ephrenm/ETBC/ETBC Hardware Files/Project Outputs for ETBC/PCB 3D Print/ETBC.jpg

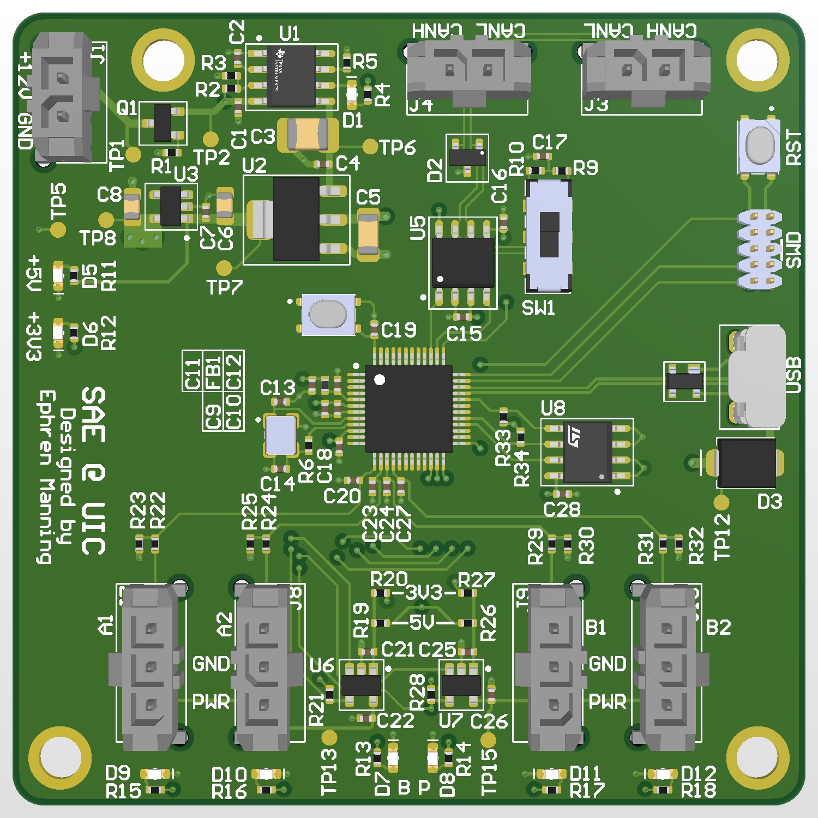
ETBC Hardware Files/Project Outputs for ETBC/PCB 3D Print/ETBC.jpg
