ephrenm/ETBC/README.md

# Electronic Throttle & Brake Controller (ETBC)
PCB designed to serve as the main controller for the brake and throttle pedal sensors on UIC's Student Formula Electric competition car. Uses an STM32G0 Cortex-M0+ in order to read analog sensor values and check for error conditions. Pedal position is communicated to the main vehicle controller using CAN 2.0A. Current version is Rev. A.

ETBC

Soldered using stencil and paste:


Designed with Altium Designer by Ephren Manning. Hardware files folder contains all design files and gerbers.
