ephrenm/ETBC/ETBC Hardware Files/Project Outputs for ETBC/Cover Page.pdf

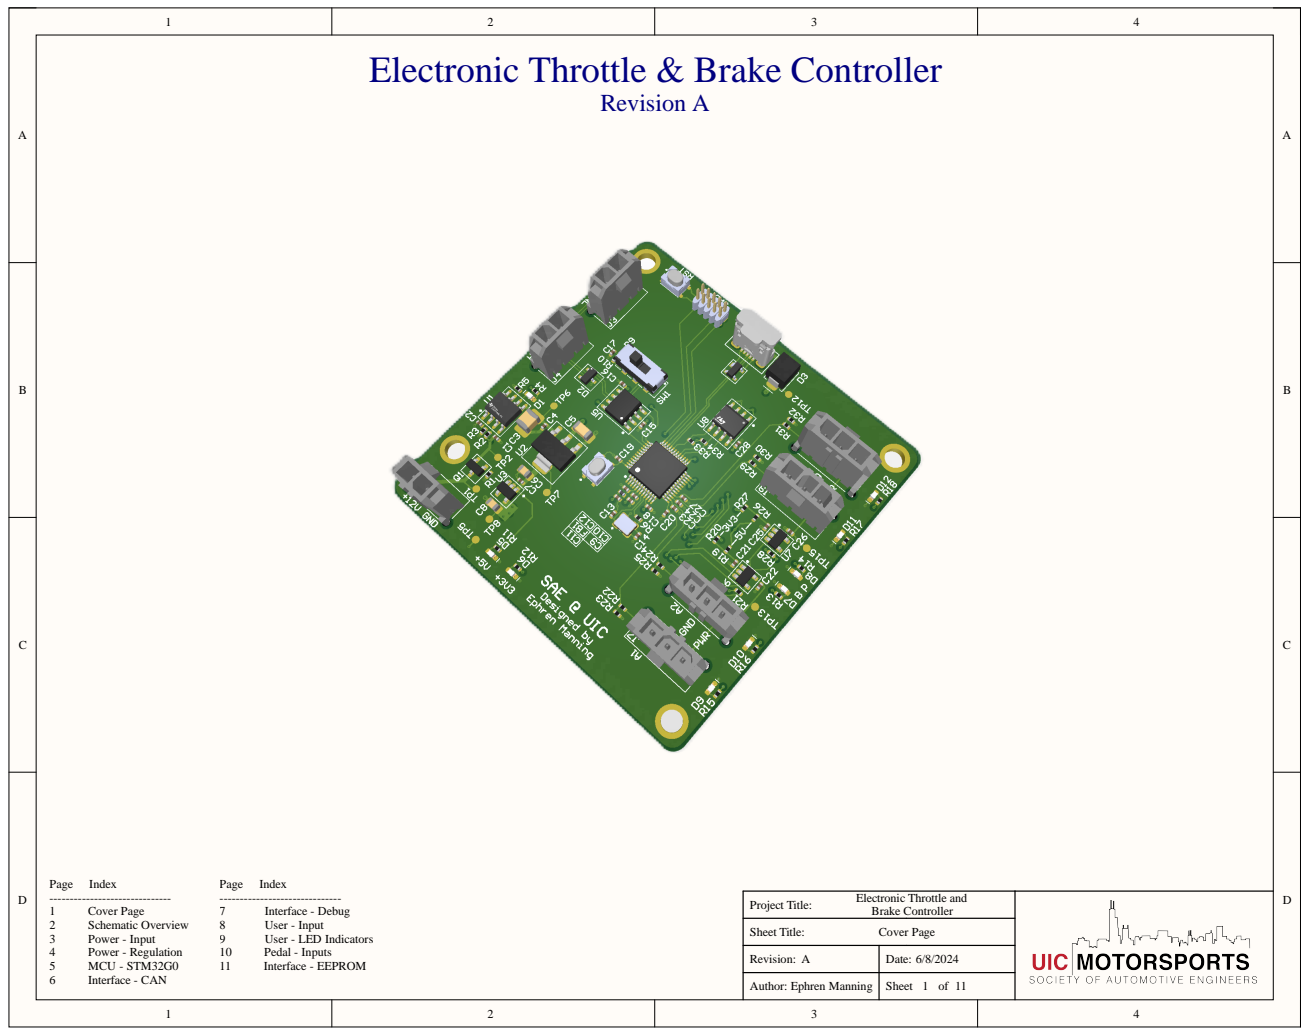
[picture p15: page 1]

Electronic Throttle & Brake Controller
