ephrenm/ETBC/ETBC Hardware Files/Project Outputs for ETBC/ETBC.pdf

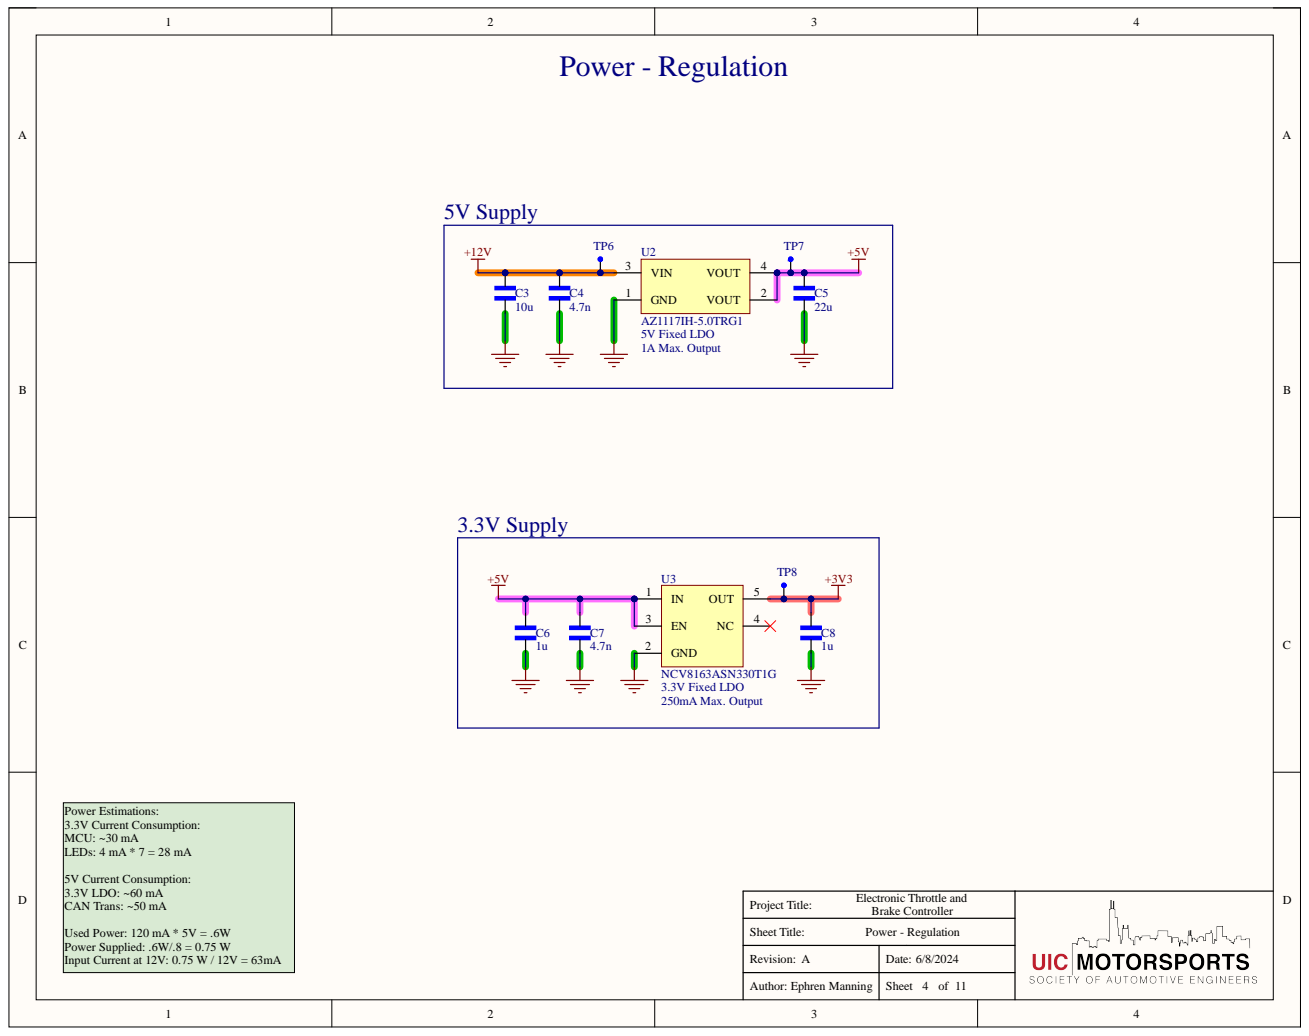
[picture p16: page 3]


SCL SDA WC EEPRO


Design Note:
DPDT Switch can be used to
enable and disable CAN bus
termination.

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

PRTR5V0U2X,215
USB TVS Diode Array


Design Note:
BTN_DEBUG is connected to a
GPIO input and can be
programmed for different
purposes.



Acceleration Pedal Position Sensor Inputs

Brake System Encoder Inputs


SCL SDA WC EEPRO
