ephrenm/ETBC/(list of files, drawings)

Other design files:
ETBC Hardware Files/Cover Page.SchDoc
ETBC Hardware Files/ETBC.PcbDoc
ETBC Hardware Files/ETBC.PrjPcb
ETBC Hardware Files/Input - Pedals.SchDoc
ETBC Hardware Files/Interface - CAN.SchDoc
ETBC Hardware Files/Interface - Debug.SchDoc
ETBC Hardware Files/Interface - EEPROM.SchDoc
ETBC Hardware Files/MCU.SchDoc
ETBC Hardware Files/Overview.SchDoc
ETBC Hardware Files/Power - Input.SchDoc
ETBC Hardware Files/Power - Regulation.SchDoc
ETBC Hardware Files/User - Input.SchDoc
ETBC Hardware Files/User - LED Indicators.SchDoc
